niemanglen/LED-cube/README.md

# LED-cube

The LED-cube is a cube formed from printed circuit boards whose faces are covered in WS2812B leds. This project contains the hardware and software used.
