niemanglen/LED-cube/hardware/README.md

Shipping will add up very quickly. The lead time on the ATMEGA's from newark can be a bit unpredictable. I recommend buying extra supplies in case some get messed up. Getting more of the pcb's does not greatly increase their price. Consider getting multiple pcb's and building more than one cube. The Memory IC is also optional and not currently used in the code.

# Parts vendors:

Tayda electronics (taydaelectronics.com)

| Part | Part Number | Quantity | Price ea | Price |
| :---: | :---: | :---: | :---: | :---: |
| Right Angle Female | A-1667 | 7 | 0.15 | 1.05 |
| 40 pin Male | A-197 | 2 | 0.15 | 0.30 |
| 40 pin Right Angle | A-199 | 1 | 0.17 | 0.17 |
| Tact Switch | A-5127 | 4 | 0.04 | 0.16 |
| Slide Switch | A-5104 | 1 | 0.22 | 0.22 |
| 10K pullup | A-3089 | 50 | 0.01 | 0.50 |
| Memory IC | A-4643 | 1 | 0.89 | 0.89 |
| Battery Holder | A-3340 | 1 | 0.27 | 0.27 |
| Battery Conn. Female | A-826 | 1 | 0.02 | 0.02 |
| Battery Conn. Male | A-804 | 1 | 0.02 | 0.02 |
| Crimp | A-837 | 2 | 0.03 | 0.06 |

Newark (newark.com)

| Part | Part Number | Quantity | Price ea | Price |
| :---: | :---: | :---: | :---: | :---: |
| ATMEGA328PB-AU | 58Y6083 | 1 | 1.61 | 1.61 |

Amazon (amazon.com)

| Part | Part Number | Quantity | Price ea | Price |
| :---: | :---: | :---: | :---: | :---: |
| WS2812B | --- | 100 | ~0.10 | ~10.00 |

JLC PCB (jlcpcb.com)

| Part | Part Number | Quantity | Price ea | Price |
| :---: | :---: | :---: | :---: | :---: |
| Side PCB | --- | 4 | --- | 2.00 |
| Top PCB | --- | 1 | --- | 4.00 |
| Bottom PCB | --- | 1 | --- | 4.00 |
