niemanglen/LED-cube/hardware/images/README.md

<!-- ![3x3_side](3x3_top.png)-->

<div>
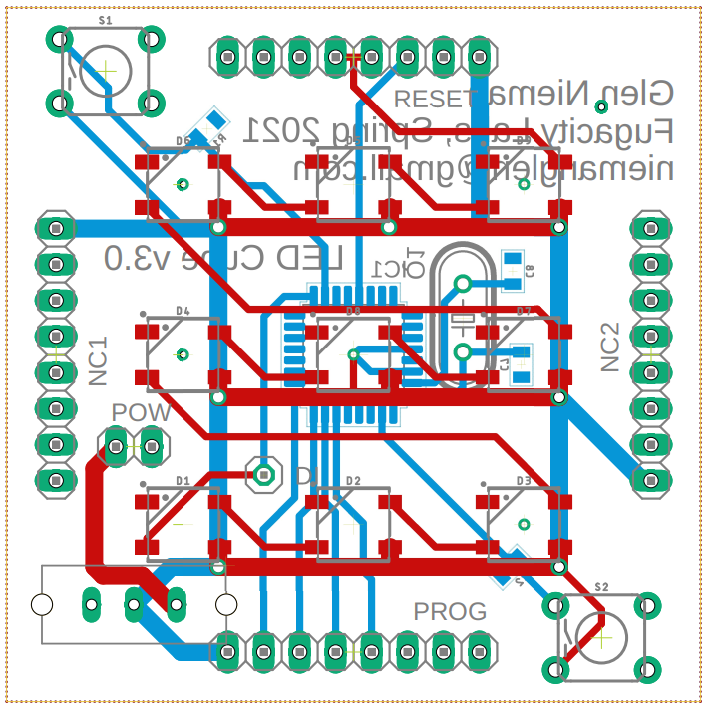
[picture p1: hardware/images/3x3_top.png]

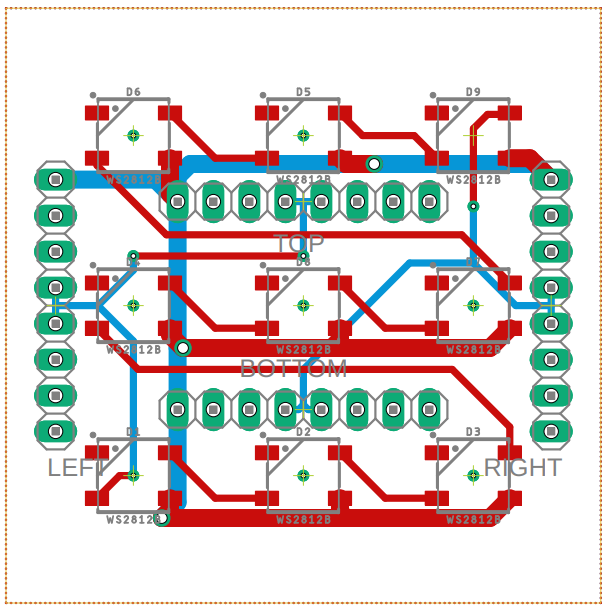
[picture p2: hardware/images/3x3_side.png]

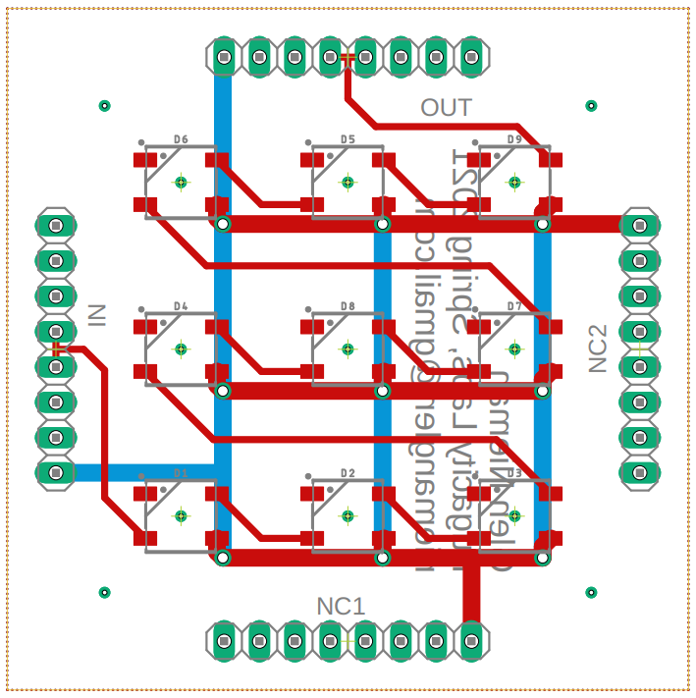
[picture p3: hardware/images/3x3_bottom.png]

</div>

<div>
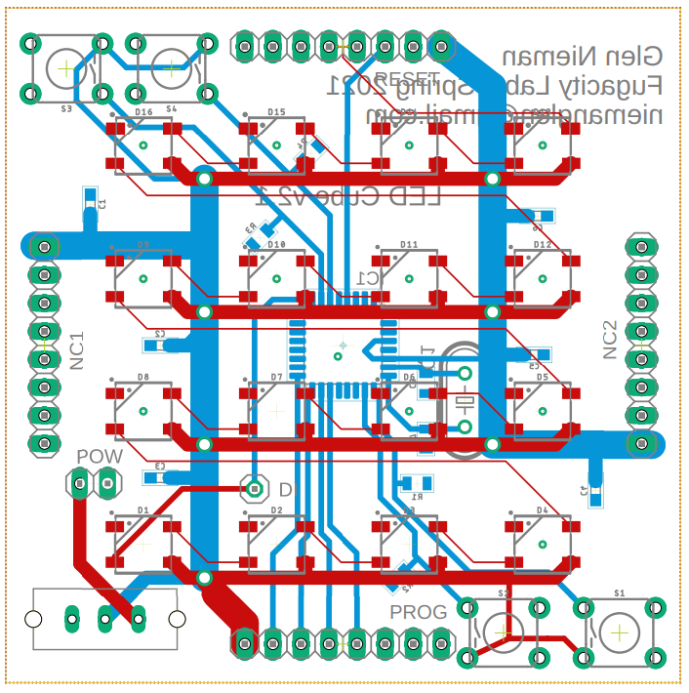
[picture p4: hardware/images/4x4_top.png]

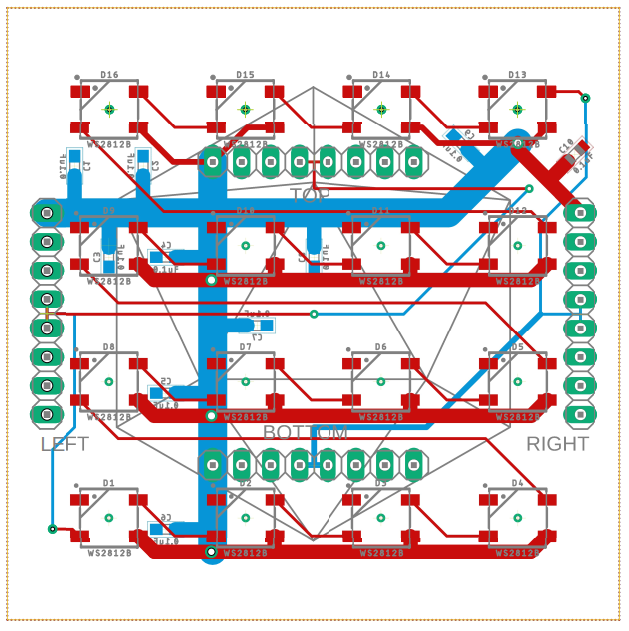
[picture p5: hardware/images/4x4_side.png]

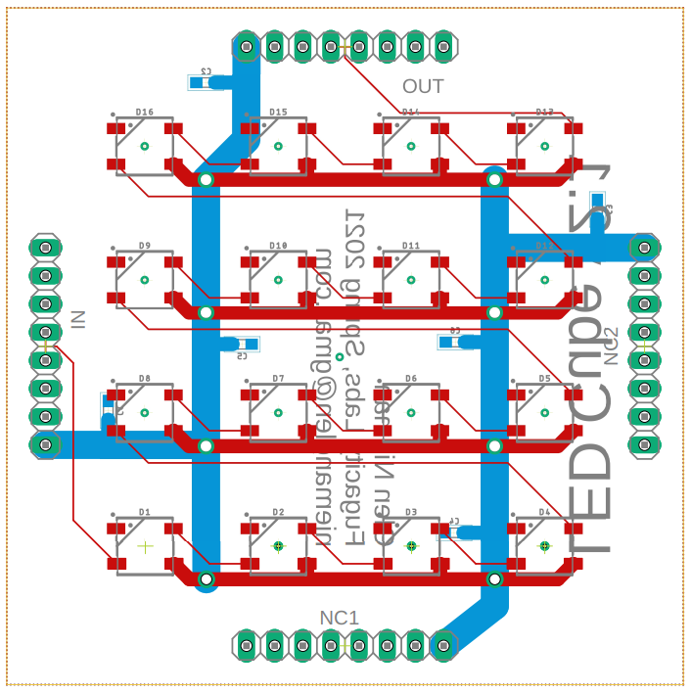
[picture p6: hardware/images/4x4_bottom.png]

</div>

<div>
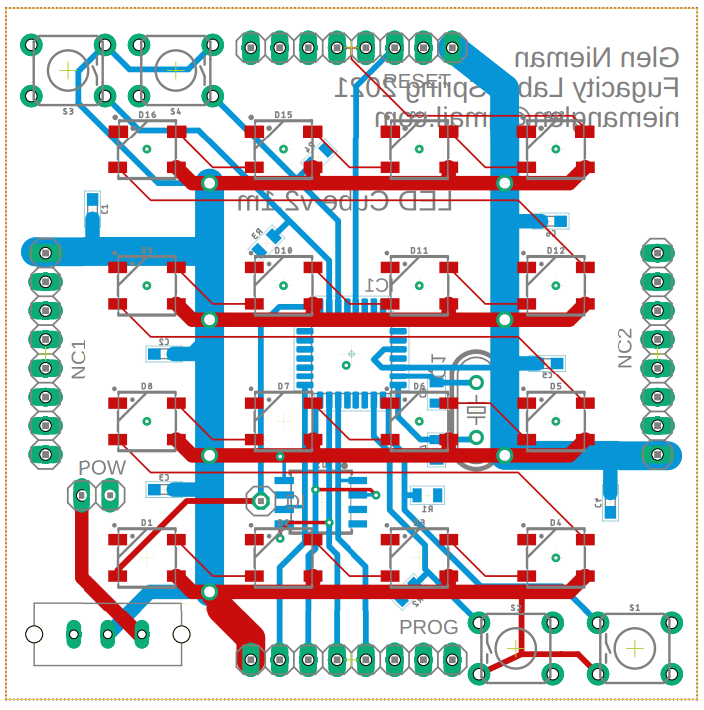
[picture p7: hardware/images/4x4_top_m.png]

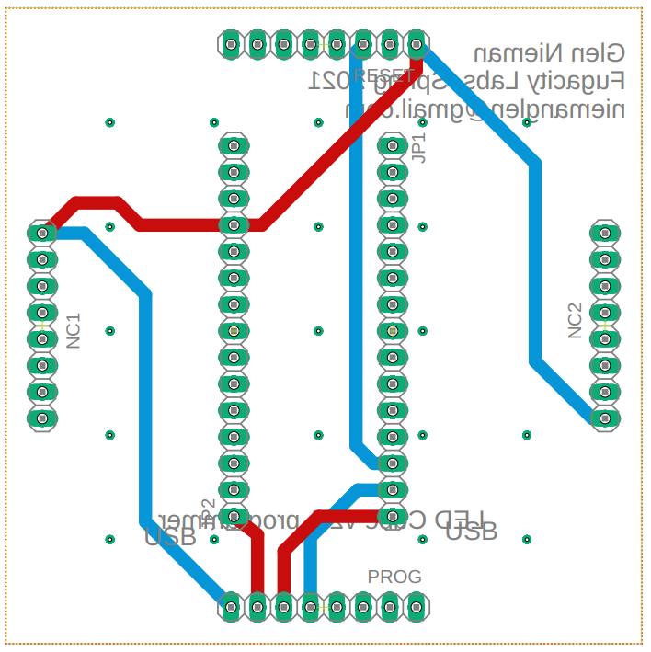
[picture p8: hardware/images/4x4_prog.png]

</div>
