niemanglen/LED-cube/hardware/eagle/3x3/top.brd

## EAGLE design hardware/eagle/3x3/top.brd (2021-07-18)

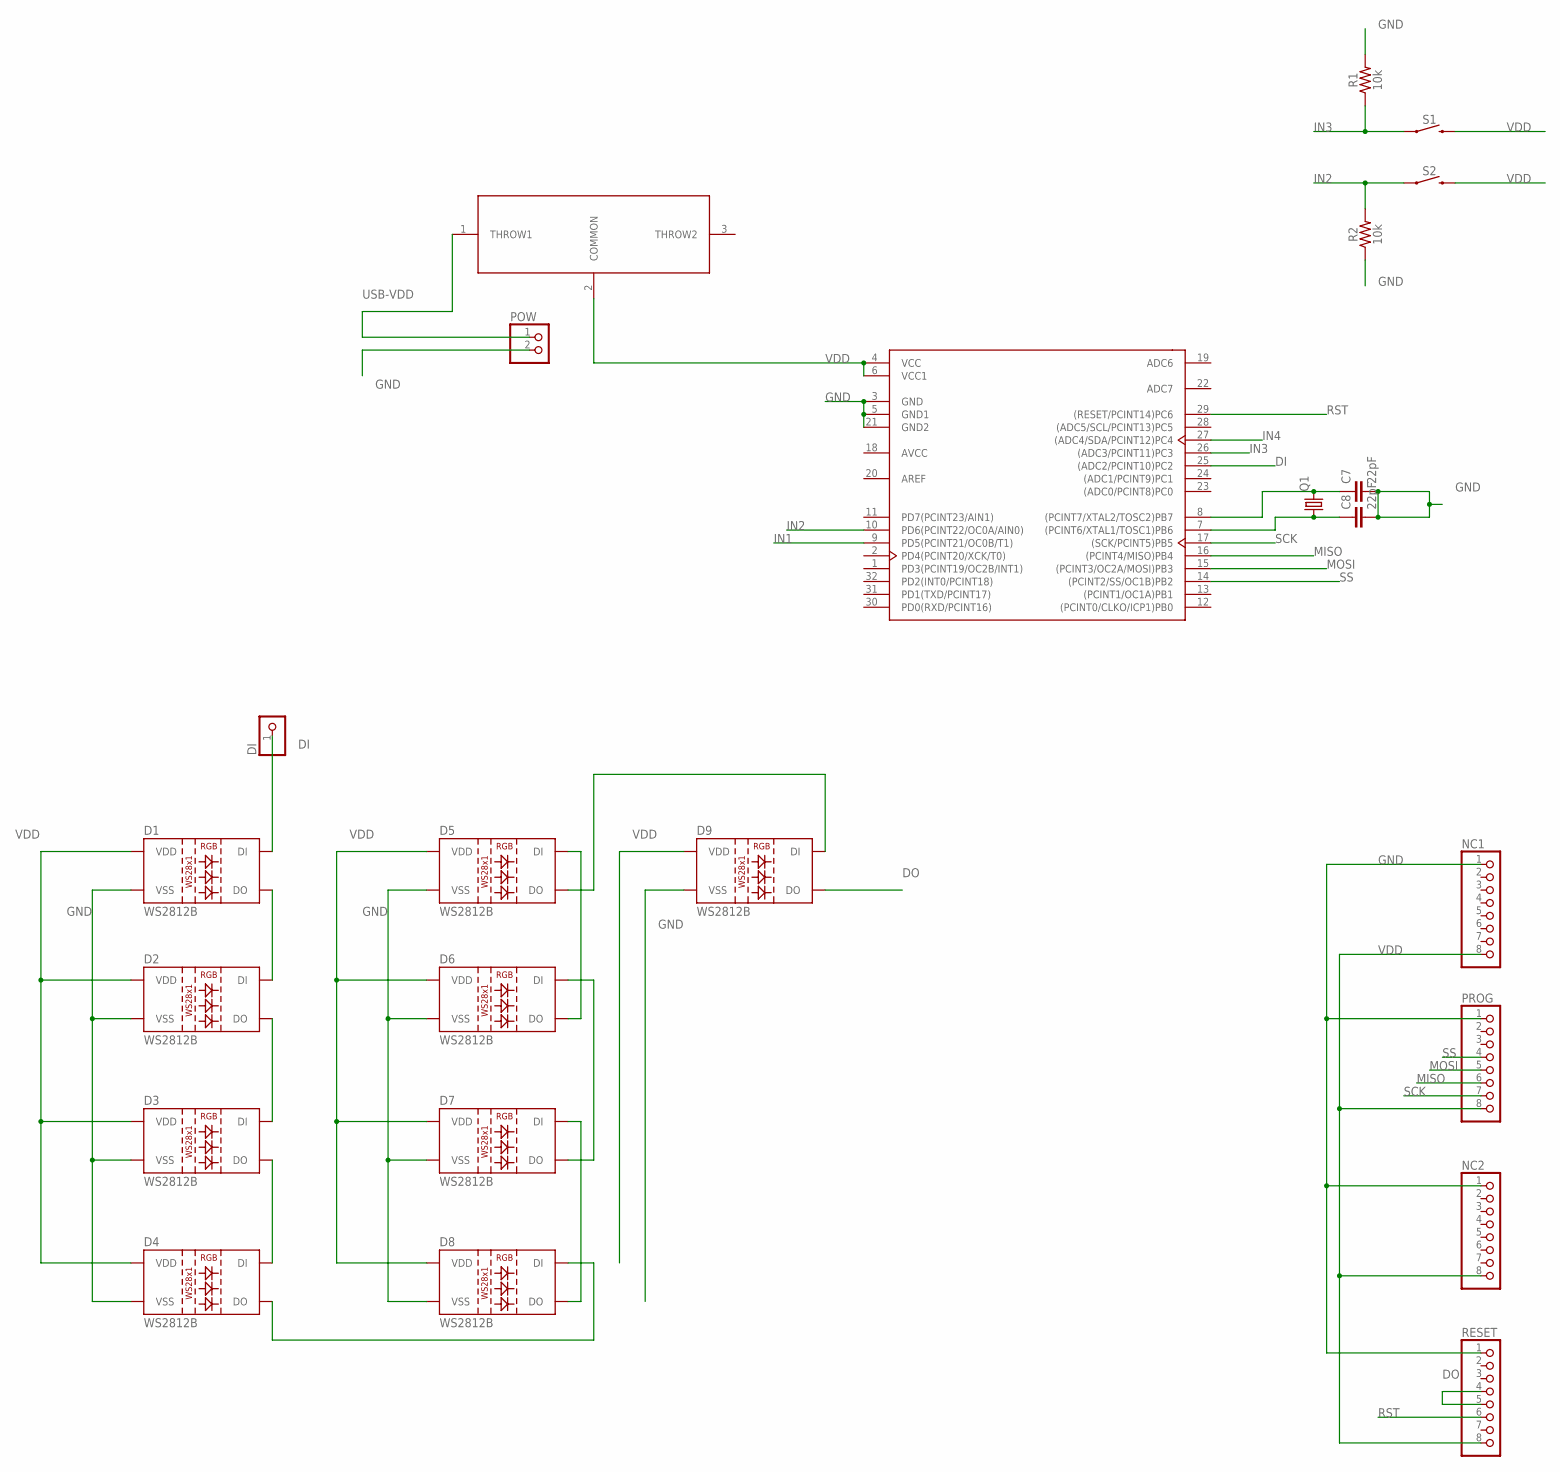
[picture p9: schematic top.sch]

Parts:
C7, C8: 22pF; 0805
D1, D2, D3, D4, D5, D6, D7, D8, D9: WS2812B
DI: PINHD-1X1; 1X01
IC1: ATMEGA328P-AU; TQFP-32
NC1, NC2: PINHD-1X8; 1X08
POW: PINHD-1X2; 1X02
PROG: PINHD-1X8; 1X08
Q1: CRYSTALHC49S; HC49/S
R1, R2: 10k; 0805
RESET: PINHD-1X8; 1X08
S1, S2: MOMENTARY-SWITCH-SPST-PTH-6.0MM; TACTILE_SWITCH_PTH_6.0MM
U$2: SLIDE_SWITCH_1P2T

Connections:
AREF: IC1.20 (AREF)
AVCC: IC1.18 (AVCC)
DI: D1.4 (DI), DI.1, IC1.25 ((ADC2/PCINT10)PC2)
DO: D9.2 (DO), RESET.4, RESET.5
GND: C7.2, C8.2, D1.3 (VSS), D2.3 (VSS), D3.3 (VSS), D4.3 (VSS), D5.3 (VSS), D6.3 (VSS), D7.3 (VSS), D8.3 (VSS), D9.3 (VSS), IC1.3 (GND), IC1.5 (GND1), IC1.21 (GND2), NC1.1, NC2.1, POW.2, PROG.1, R1.2, R2.1, RESET.1
IN1: IC1.9 (PD5(PCINT21/OC0B/T1))
IN2: IC1.10 (PD6(PCINT22/OC0A/AIN0)), R2.2, S2.1
IN3: IC1.26 ((ADC3/PCINT11)PC3), R1.1, S1.1
IN4: IC1.27 ((ADC4/SDA/PCINT12)PC4)
MISO: IC1.16 ((PCINT4/MISO)PB4), PROG.6
MOSI: IC1.15 ((PCINT3/OC2A/MOSI)PB3), PROG.5
unnamed: D4.2 (DO), D8.4 (DI)
unnamed: D7.4 (DI), D8.2 (DO)
unnamed: D1.2 (DO), D2.4 (DI)
unnamed: D2.2 (DO), D3.4 (DI)
unnamed: D3.2 (DO), D4.4 (DI)
unnamed: D6.4 (DI), D7.2 (DO)
unnamed: D5.2 (DO), D9.4 (DI)
unnamed: C7.1, IC1.8 ((PCINT7/XTAL2/TOSC2)PB7), Q1.2
unnamed: D5.4 (DI), D6.2 (DO)
unnamed: C8.1, IC1.7 ((PCINT6/XTAL1/TOSC1)PB6), Q1.1
RST: IC1.29 ((RESET/PCINT14)PC6), RESET.6
SCK: IC1.17 ((SCK/PCINT5)PB5), PROG.7
SS: IC1.14 ((PCINT2/SS/OC1B)PB2), PROG.4
USB-VDD: POW.1, U$2.1 (THROW1)
VDD: D1.1 (VDD), D2.1 (VDD), D3.1 (VDD), D4.1 (VDD), D5.1 (VDD), D6.1 (VDD), D7.1 (VDD), D8.1 (VDD), D9.1 (VDD), IC1.4 (VCC), IC1.6 (VCC1), NC1.8, NC2.8, PROG.8, RESET.8, S1.3 (2), S2.3 (2), U$2.2 (COMMON)

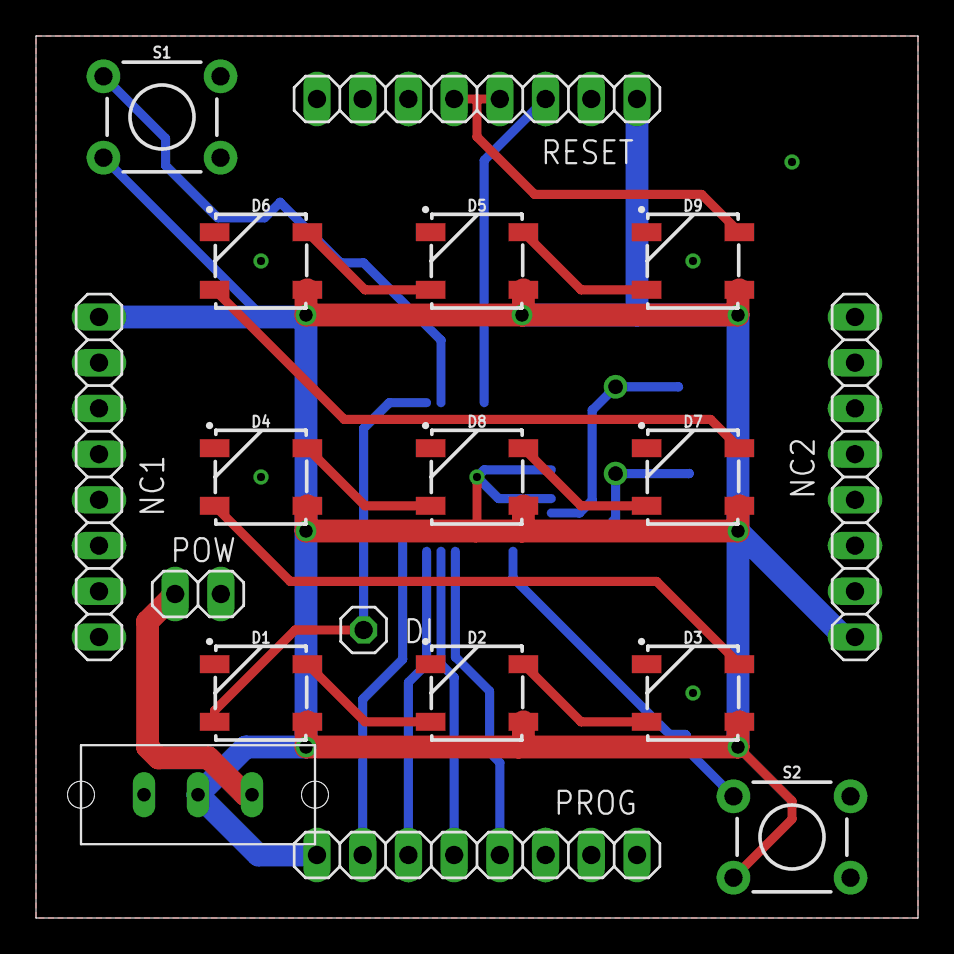
[picture p10: board top.brd from above]

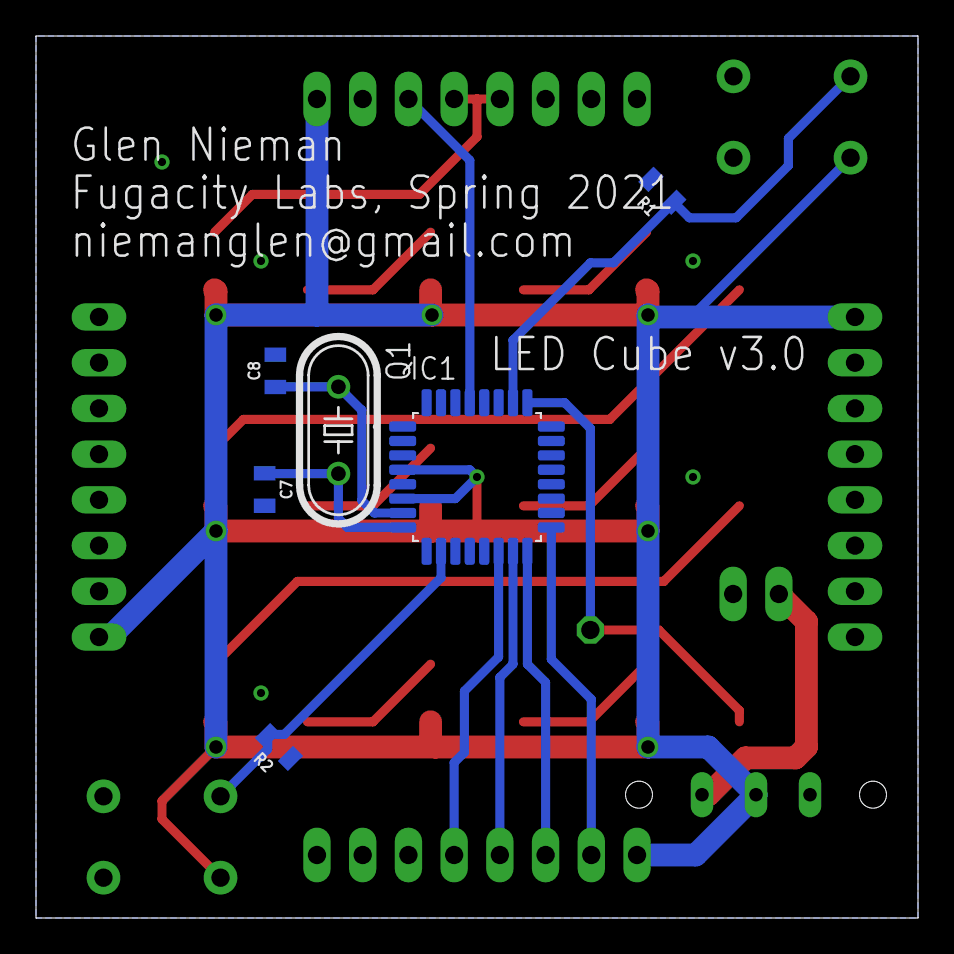
[picture p11: board top.brd from below]

Board: 2 copper layers, 49.0 x 49.0 mm, 24 parts (6 on the bottom side), 22 nets.
