niemanglen/LED-cube/hardware/eagle/4x4/top_prog.brd

## EAGLE design hardware/eagle/4x4/top_prog.brd (2021-07-18)

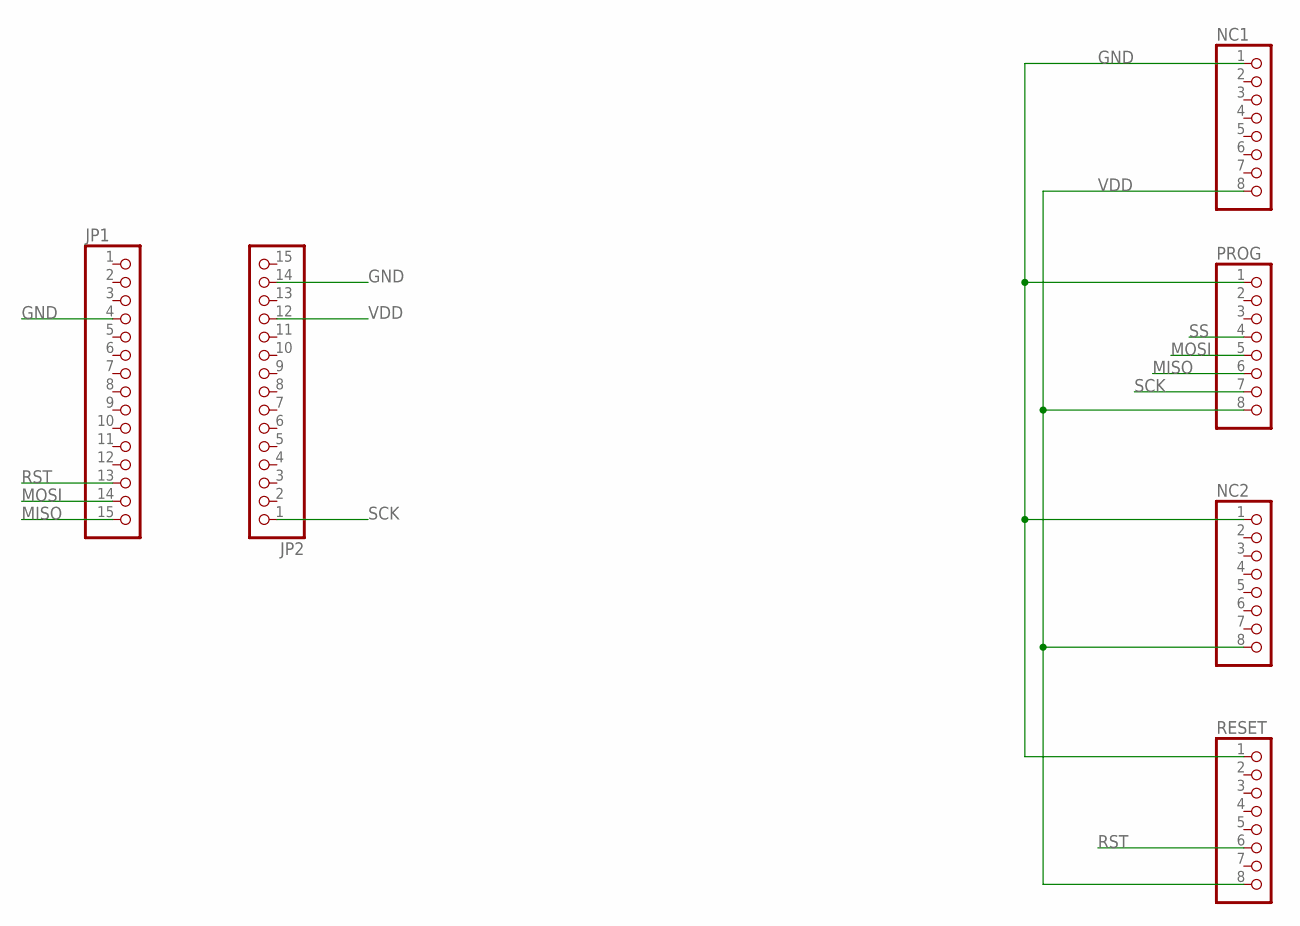
[picture p12: schematic top_prog.sch]

Parts:
JP1, JP2: PINHD-1X15; 1X15
NC1, NC2: PINHD-1X8; 1X08
PROG: PINHD-1X8; 1X08
RESET: PINHD-1X8; 1X08

Connections:
GND: JP1.4, JP2.14, NC1.1, NC2.1, PROG.1, RESET.1
MISO: JP1.15, PROG.6
MOSI: JP1.14, PROG.5
RST: JP1.13, RESET.6
SCK: JP2.1, PROG.7
SS: PROG.4
VDD: JP2.12, NC1.8, NC2.8, PROG.8, RESET.8

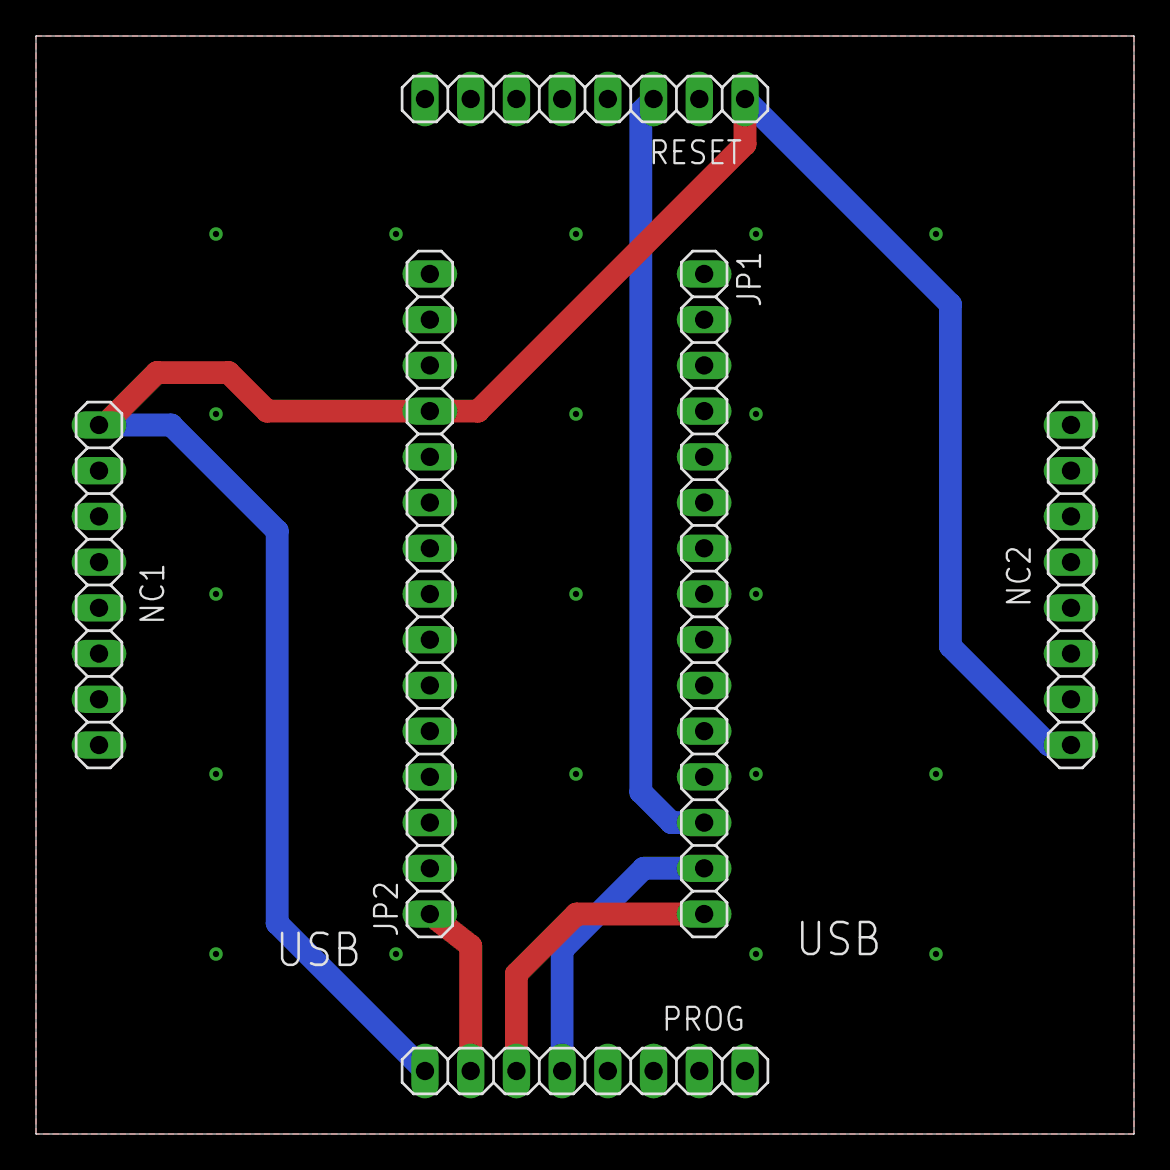
[picture p13: board top_prog.brd from above]

Board: 2 copper layers, 61.0 x 61.0 mm, 6 parts (0 on the bottom side), 6 nets.
